MkinG2k0/enduro-v2/tools/_preview-cutoff.png

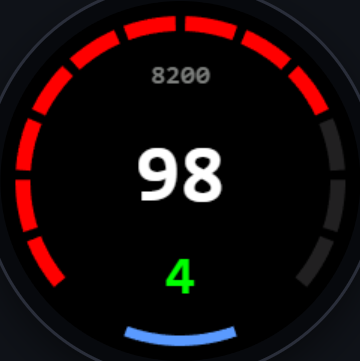
tools/_preview-cutoff.png
