MkinG2k0/enduro-v2/tools/ui-constructor.html

# Enduro — конструктор приборки

Живой превью на плату по USB (Chrome). «Сохранить на плату» пишет конфиг в EEPROM — переживает перезагрузку.

Подключить Отключить Демо

Сохранить на плату Сброс платы

Не подключено. Нужен http://localhost (не file://).

USB — лог

Живая отправка на плату

Все элементы вкл Все элементы выкл

Обороты

Дуга RPM Цифра RPM Внешнее кольцо Деления секций Отсечка (shift light)

Дуга RPM, зоны, цифра и превью.

Превью Макс. Шаг деления (об/мин)

Делений: 12

Жёлтая зона Красная зона Порог отсечки Мигание мс

При ≥ порога дуга мигает белый ↔ красный.

Размер цифры Позиция Y Внешний радиус Толщина дуги Зазор ° Старт ° Дуга ° Шаг отрисовки °

Скорость

Показывать скорость Превью Размер цифры

Передача

Показывать передачу Превью Размер цифры Позиция Y

Дальний

Показывать дальний Превью включён Центр ° Дуга ° Высота (радиус) Толщина

Высота — внешний радиус; дуга остаётся круглой вокруг центра.

Шрифт (общий)

Семейство для всех цифр. Размеры — в секциях Обороты / Скорость / Передача.

Семейство

Заставка (boot)

Анимация дуги Показывать версию

Дефолты в прошивке. На уже запущенной плате действуют после ребута/прошивки.

Размер текста Показ версии мс Пауза секции мс

Профили

Имя Сохранённые

Сохранить Загрузить Удалить

Экспорт дефолтов

Сгенерировать Копировать Сбросить

Превью 240×240 и живой экран GC9A01 после подключения.
