MkinG2k0/enduro-v2/docs/wiring-promicro-gc9a01-mpu6050.png

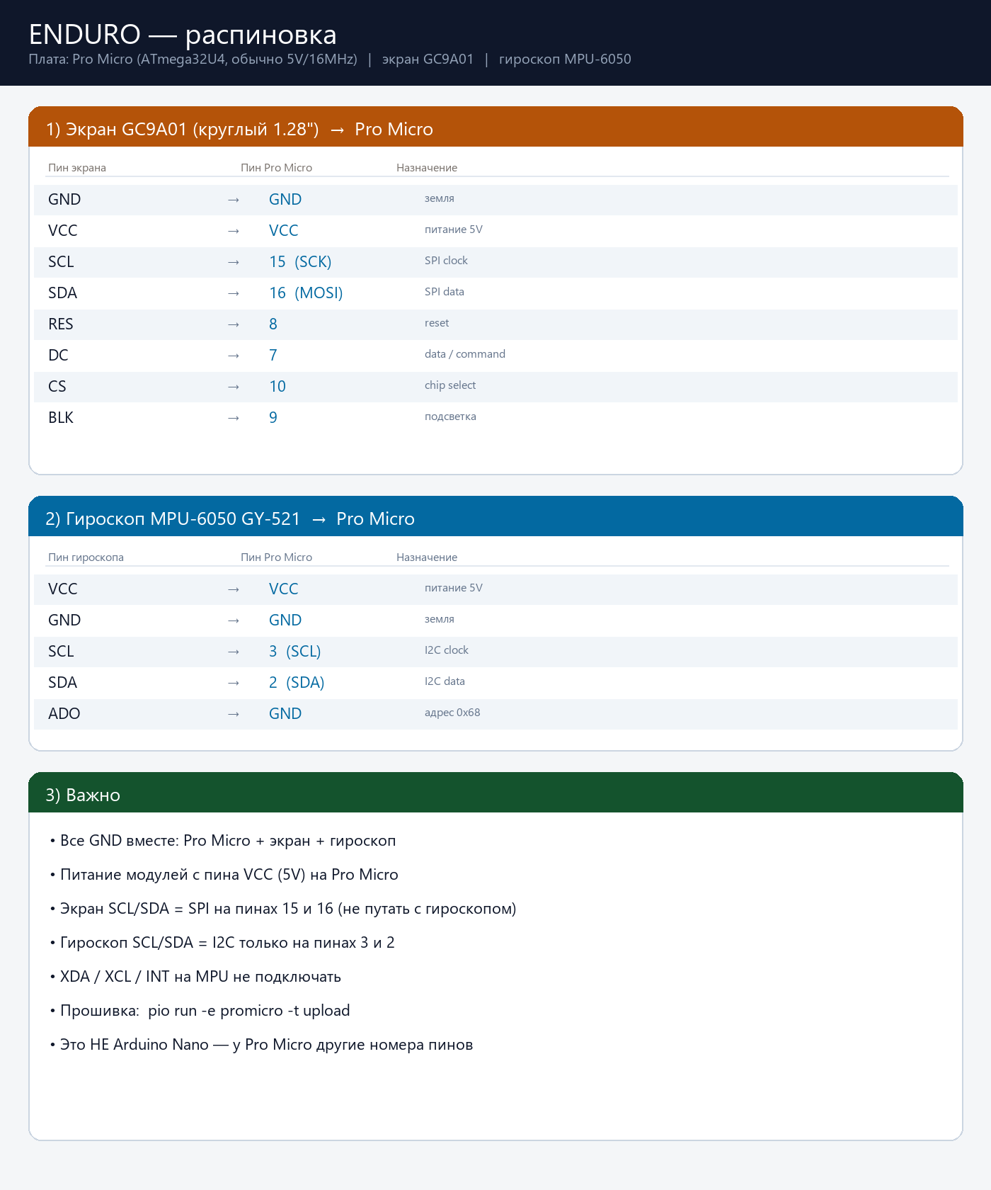
docs/wiring-promicro-gc9a01-mpu6050.png
