MkinG2k0/enduro-v2/(commit log)

2026-11-11 Initial commit: Enduro-v2 rider UI firmware and docs.
    PlatformIO firmware for Pro Micro + GC9A01, wiring docs, and UI constructor tools.
2026-11-11 Document the project for newcomers in README.
    Explain purpose, hardware stack, data flow, build steps, and sync HARDWARE status with FW 2.3.0.
